dalori/ESP32-uncanny-eyes-halloween-skull/wiring/wiring.png

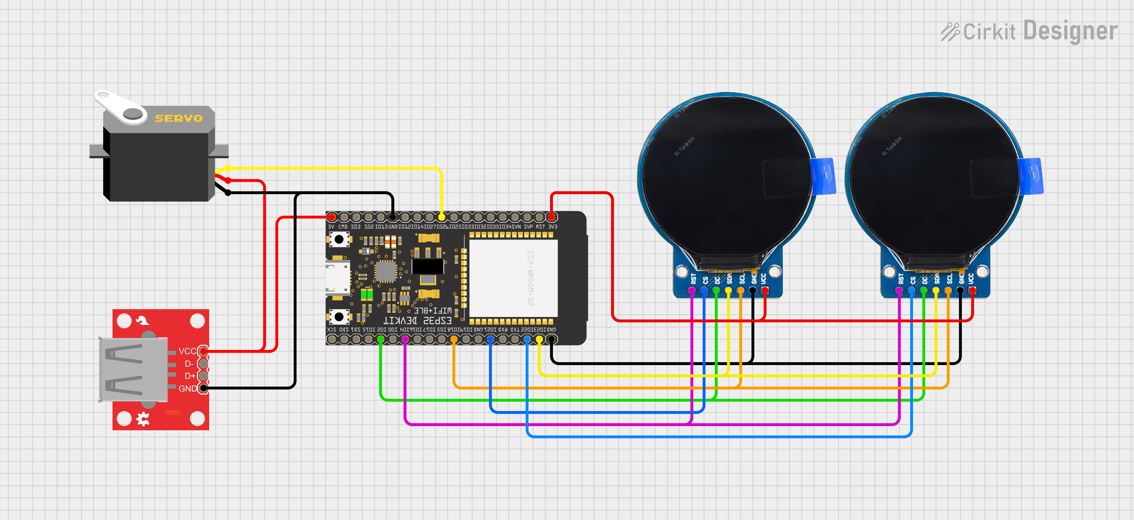
wiring/wiring.png
