dalori/ESP32-uncanny-eyes-halloween-skull/(threads)

Thread 1 (2024-07-19):

Add some detail about setting up the TFT_eSPI library

teshdor, 2024-07-19:
For those that struggled to set this up. After you install the TFT_eSPI library, you need to go into the Arduino library folder for TFT_eSPI and comment out the line that reads "#include <User_Setup.h>" and then uncomment out the line that reads: "#include <User_Setups/Setup46_GC9A01_ESP32.h>". Otherwise you will just get a blank screen since this library supports a number of different boards and displays.

kaliboe3d, 2024-09-26:
I uploaded this code, one eye is flickering (seems that the black lid is switching from left to right all the time) the other eye is working fine. when I change the code and place #define NUM_EYES 2 to 1, both eyes are working fine bud they have both left (or right) eyes what looks on-natural. Cannot find out what's wrong here

randyr505, 2024-09-27:
I have the same issue as kaliboe3d. I am using board ESP-WROOM-32
